estjuandcastaneda-06/Parcial-2-corte-/planos/planos_completos.pdf

## PLANTA — placa superior transparente; en línea punteada lo que queda debajo

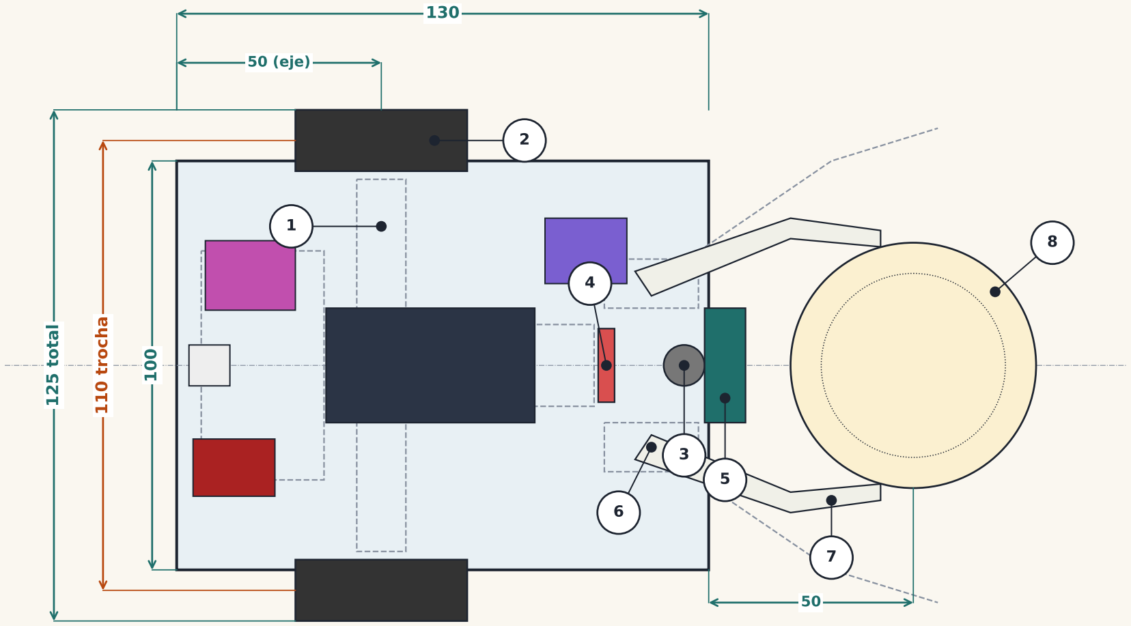
[picture p1: figure]
50 (eje); 110 trocha; 125 total
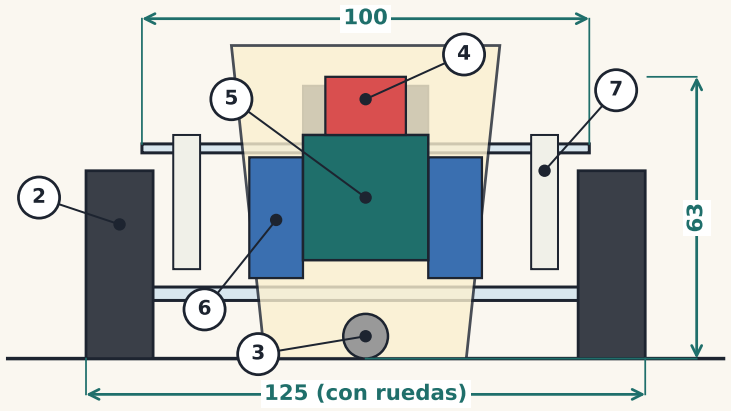
[picture p2: figure]
125 (con ruedas)

FRENTE

## VISTA LATERAL (el frente sale por la derecha)

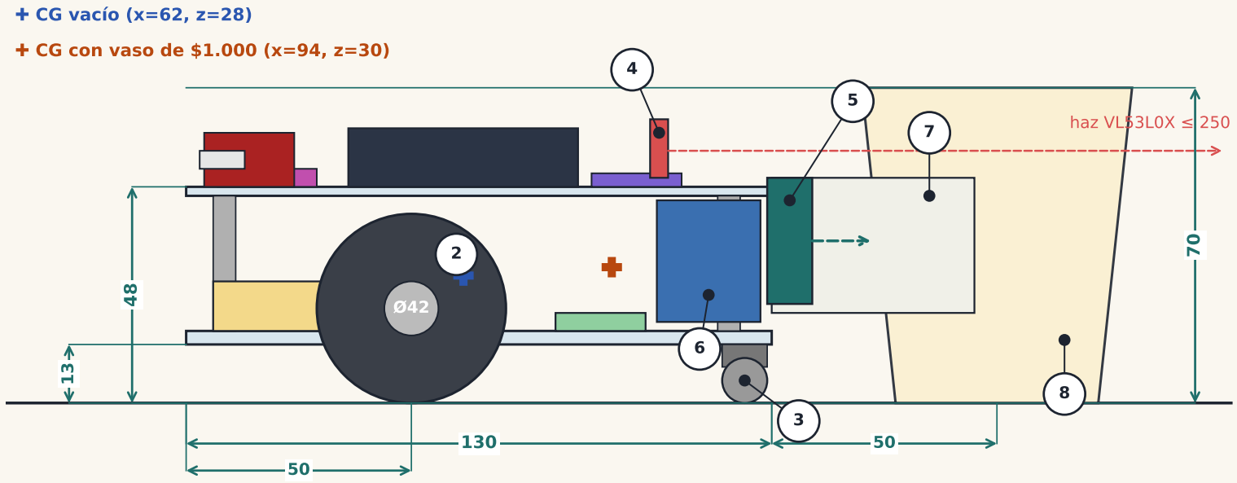
[picture p3: figure]
haz VL53L0X ≤ 250; ✚ CG vacío (x=62, z=28)

✚ CG con vaso de $1.000 (x=94, z=30) 48 13

## VISTA FRONTAL

## NOTAS

- Chasis de 2 placas (130×100; 3 y 2 mm), separadas 30 mm.
- Tracción diferencial, trocha 110 mm, eje a 50 mm del borde trasero.
- TCS3200 en la palma de la pinza, a ≈15 mm del vaso (su rango útil).
- VL53L0X atrás (x=105): con el vaso agarrado lee ≈45 mm (mín. fiable ≈30).
- Peso vacío 290 g; cargado 401 g (vaso + 10×$1.000).

## - CG con vaso en x=94 (entre eje 50 y loca 124): no vuelca

(límite ≥ 9.6 m/s²; el carrito usa < 1 m/s²).
- Medidas del vaso y de los N20/ruedas: supuestas, verificar con las piezas.

### LEYENDA

## 1 Motorreductor N20 + encoder (2) 2 Rueda Ø42 × 15 (2) 3 Rueda loca (bola Ø10) 4 VL53L0X: distancia / detecta vasos 5 TCS3200: color del vaso (en la palma) 6 Servo SG90 de la pinza (2) 7 Dedos de pinza impresos (2) 8 Vaso con 10 monedas (Ø60 × 70)

# Carrito hormiga — vistas y cotas

# Medidas en mm · tracción diferencial · pinza frontal con sensor de color en la palma

ENJAMBRE DE CARRITOS HORMIGA

## Lám. 1/7 · Esc. 1:1 por vista · mm

## Fecha 2026-10-04

## [Integrantes del grupo]

## PISO INFERIOR (sobre la placa de 3 mm) y zona de pinza entre placas

## PISO SUPERIOR (sobre la placa de 2 mm)

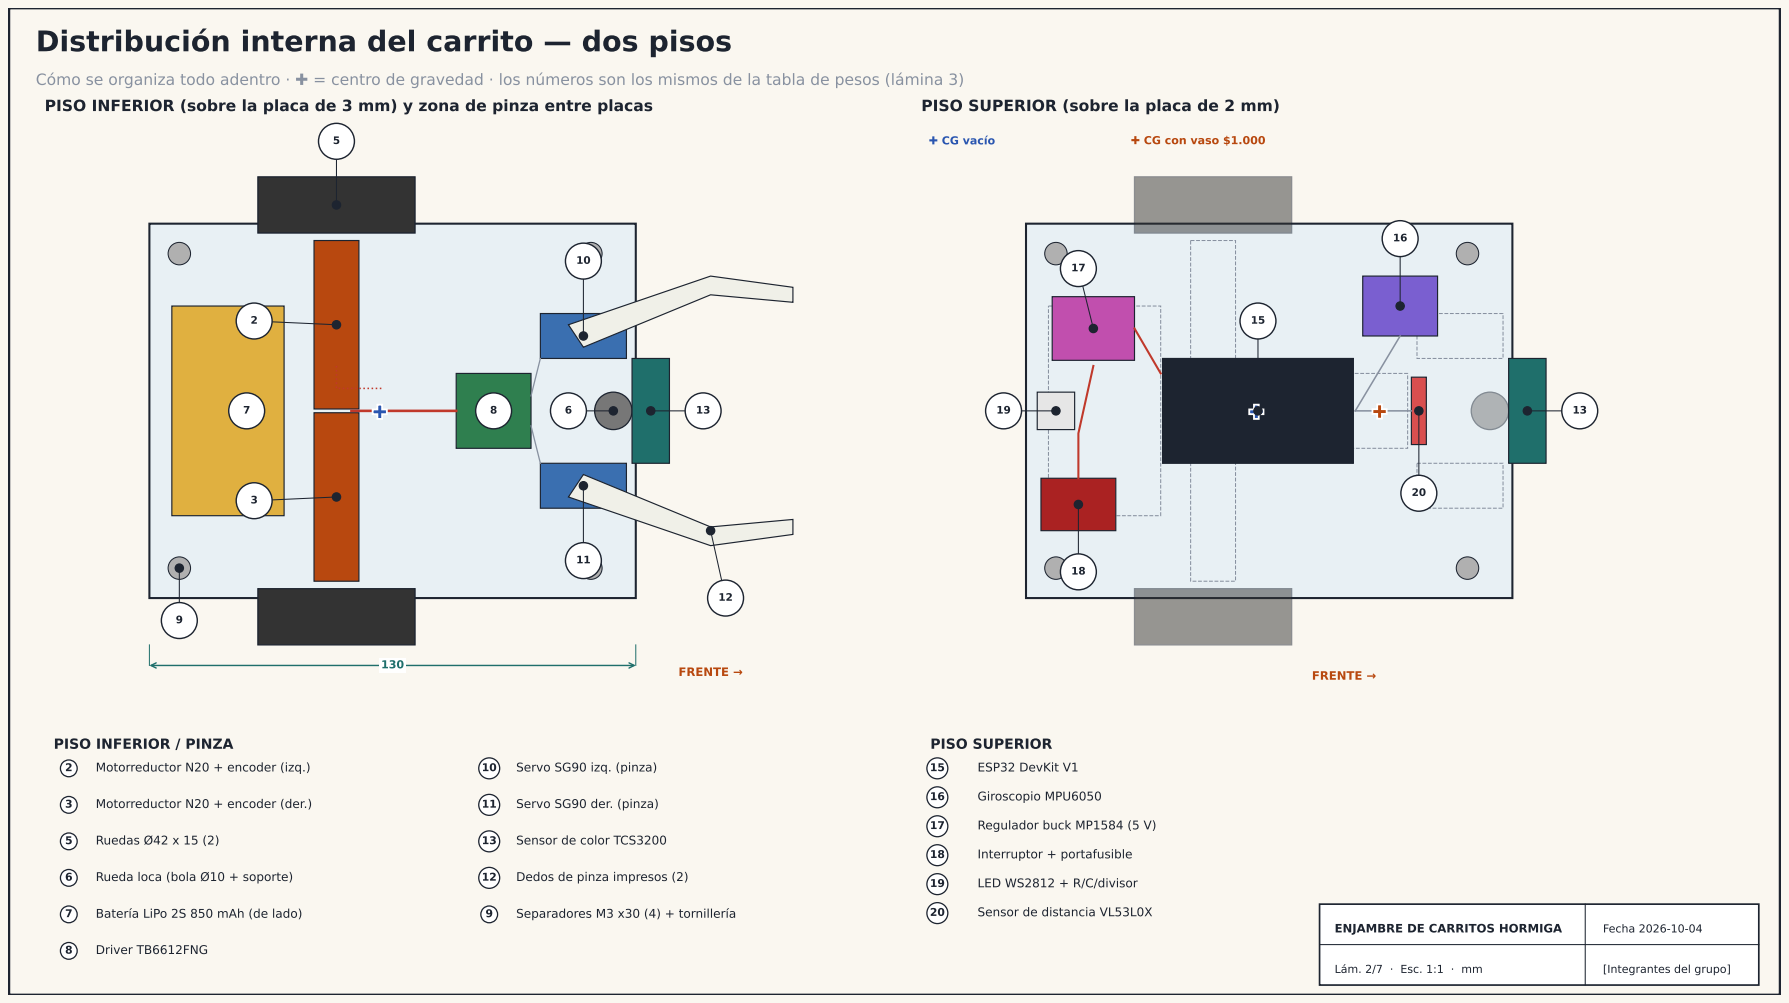
[picture p4: page 2]
FRENTE →; ✚ CG vacío; ✚ CG con vaso $1.000; 5 Ruedas Ø42 x 15 (2); 8 Driver TB6612FNG; 9 Separadores M3 x30 (4) + tornillería; PISO SUPERIOR; 15 ESP32 DevKit V1; 16 Giroscopio MPU6050; 17 Regulador buck MP1584 (5 V); 18 Interruptor + portafusible; 19 LED WS2812 + R/C/divisor

Distribución interna del carrito — dos pisos

Cómo se organiza todo adentro · ✚ = centro de gravedad · los números son los mismos de la tabla de pesos (lámina 3)

PISO INFERIOR / PINZA

2 Motorreductor N20 + encoder (izq.)

10 Servo SG90 izq. (pinza)

3 Motorreductor N20 + encoder (der.)

11 Servo SG90 der. (pinza)

13 Sensor de color TCS3200

6 Rueda loca (bola Ø10 + soporte)

12 Dedos de pinza impresos (2)

7 Batería LiPo 2S 850 mAh (de lado)

20 Sensor de distancia VL53L0X

Lám. 2/7 · Esc. 1:1 · mm

## PESO POR COMPONENTE (g)

N° | Componente | Piso | Masa
1 | Placa inferior acrílico 3 mm | inferior | 46
2 | Motorreductor N20 + encoder (izq.) | inferior | 14
3 | Motorreductor N20 + encoder (der.) | inferior | 14
4 | Soportes de motor (2) | inferior | 6
5 | Ruedas Ø42 x 15 (2) | inferior | 22
6 | Rueda loca (bola Ø10 + soporte) | inferior | 6
7 | Batería LiPo 2S 850 mAh (de lado) | inferior | 55
8 | Driver TB6612FNG | inferior | 3
9 | Separadores M3 x30 (4) + tornillería | inferior | 14
10 | Servo SG90 izq. (pinza) | pinza | 9
11 | Servo SG90 der. (pinza) | pinza | 9
12 | Dedos de pinza impresos (2) | pinza | 8
13 | Sensor de color TCS3200 | pinza | 12
14 | Placa superior acrílico 2 mm | superior | 31
15 | ESP32 DevKit V1 | superior | 10
16 | Giroscopio MPU6050 | superior | 3
17 | Regulador buck MP1584 (5 V) | superior | 2
18 | Interruptor + portafusible | superior | 8
19 | LED WS2812 + R/C/divisor | superior | 4
20 | Sensor de distancia VL53L0X | superior | 1.5
21 | Cableado y terminales | superior | 12
| MASA DEL CARRITO VACÍO | | 290 g
| + vaso (12 g) con 10 monedas de $1.000 (9,95 g c/u) | | 112 g
| MASA CARGADO (peor caso) | | 401 g

Carga útil por denominación (vaso de 12 g + 10 monedas): $50: 32 g $100: 45 g $200: 58 g $500: 83 g $1000: 112 g

0.00 | 0.25 | 0.50 | 0.75 | 1.00 | 1.25 | 1.50 | 1.75 | 2.00
potencia media tomada de la batería (W)

2× motor N20

ESP32 + ESP-NOW

Sensores (color,
ToF, IMU, enc.)

2× servo SG90
(uso medio)

LED WS2812

### 1.60 W

### 0.91 W

### 0.45 W

### 0.23 W

### 0.06 W

## CONSUMO MEDIO TOTAL ≈ 3.24 W

## CORRIENTES Y DIMENSIONAMIENTO

| media | pico
Riel 5 V (ESP32 + sensores + servos + LED) | 289 mA | 1449 mA
Batería 7,4 V (todo, con pérdidas del buck/driver) | 438 mA | 2194 mA
Potencia total | 3.2 W | 16.2 W
- Batería LiPo 2S 850 mAh = 6.29 Wh; usable 80 % → autonomía ≈ 1.6 h (teórica; esperar ≈1 h real).
- Pico = ambos motores bloqueados (600 mA c/u) + ambos servos a

500 mA: dura < 1 s.

- Buck MP1584 (3 A) con condensador de 1000 µF en el riel de 5 V:

los servos NO deben reiniciar el ESP32.

- Fusible de 3 A en la batería; motores N20 de 6 V con PWM

limitado al 80 % (batería 7,4 V).

- TB6612FNG: 1,2 A continuos por canal: sobra para 2 N20 (< 0,6 A

de pico).

## RESUMEN

290 g

vacío

401 g

con vaso de $1.000 (peor caso)

# 3.2 W

consumo medio (438 mA a 7,4 V)

≈ 1.6 h

autonomía teórica

# x = 94 mm

CG con vaso (eje 50 · loca 124)

# 9.6 m/s²

aceleración que haría volcar (uso real < 1)

# Peso, consumo y estabilidad del carrito

## Valores estimados con hojas de datos típicas: hay que pesar y medir las piezas reales

Lám. 3/7 · Esc. s/e · mm

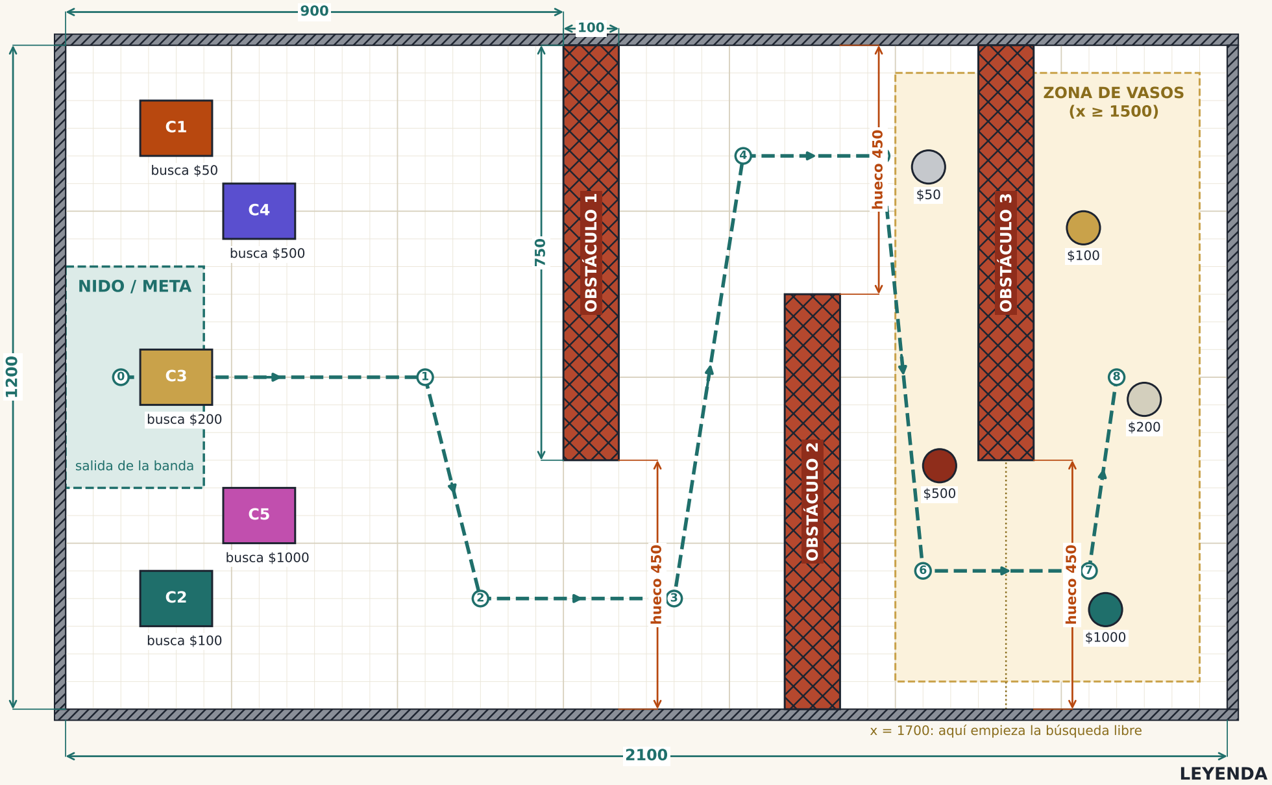
[picture p5: figure]
NIDO / META; salida de la; banda; ZONA DE VASOS; OBSTÁCULO 1; OBSTÁCULO 2; OBSTÁCULO 3; busca $1000; busca $50; busca $100; busca $200; busca $500; hueco 450; LEYENDA

x = 1700: aquí empieza la búsqueda libre

COORDENADAS (mm; origen en la esquina superior izquierda, x → derecha, y ↓ abajo)

- Nido / meta: (100, 600) · bahía de entrega 250 × 400
- Obstáculo 1: x 900–1000, y 0–750 · Obstáculo 2: x 1300–1400, y 450–1200 · Obstáculo 3: x 1650–1750, y 0–750
- Corredor 0→8: (100,600) (650,600) (750,1000) (1100,1000) (1225,200) (1475,200) (1550,950) (1850,950) (1900,600)
- Salidas: C1 (200,150) · C2 (200,1000) · C3 (200,600) · C4 (350,300) · C5 (350,850) → cada carrito busca UNA denominación
- Paredes de 60 mm de alto (el VL53L0X las ve y el campo potencial las evita). Piso mate claro, sin brillos (TCS3200).
- Cuadrícula de la simulación: 42 × 24 celdas de 50 mm (línea fina); cada 300 mm línea gruesa.
obstáculo (pared 60 mm) | corredor nido → zona
zona de vasos | nido / meta

# Plano de la arena de los carritos

## Mismas coordenadas que usa la simulación (swarm.py) y el URDF de PyBullet · cotas en mm

Lám. 4/7 · Esc. ≈ 1:10 · mm

## VISTA SUPERIOR — arena de 2100 × 1200 mm (1 hoja de MDF de 1220 × 2440 mm)

Flechas: salida del ESP32 → módulo (OUT) · módulo → ESP32 (IN: encoders y OUT del TCS3200) · punto = bus compartido

## ALIMENTACIÓN

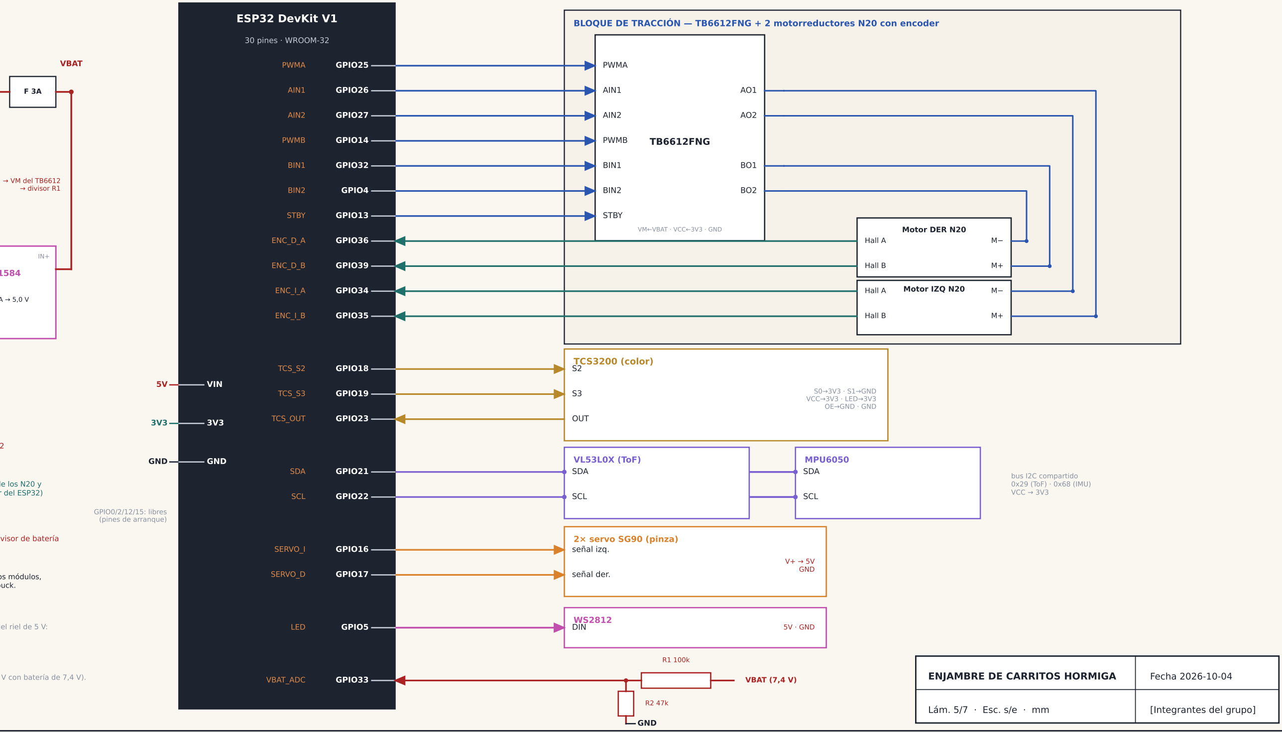
[picture p6: figure]
bus I2C compartido 0x29 (ToF) · 0x68 (IMU) VCC → 3V3; VBAT (7,4 V); VBAT; → VM del TB6612 → divisor R1; ESP32 DevKit V1; 30 pines · WROOM-32; PWMA; GPIO25; AIN1; GPIO26; AIN2; GPIO27; PWMB; GPIO14; BIN1; GPIO32; BIN2; GPIO4; STBY; GPIO13; ENC_D_A; GPIO36; ENC_D_B; GPIO39; ENC_I_A; GPIO34; ENC_I_B; GPIO35; TCS_S2; GPIO18; TCS_S3; GPIO19; TCS_OUT; GPIO23; SDA; GPIO21; SCL; GPIO22; SERVO_I; GPIO16; SERVO_D; GPIO17; LED; GPIO5; VBAT_ADC; GPIO33; VIN; GND; GPIO0/2/12/15: libres (pines de arranque); TB6612FNG; VM←VBAT · VCC←3V3 · GND; Motor DER N20; Motor IZQ N20; Hall A; Hall B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
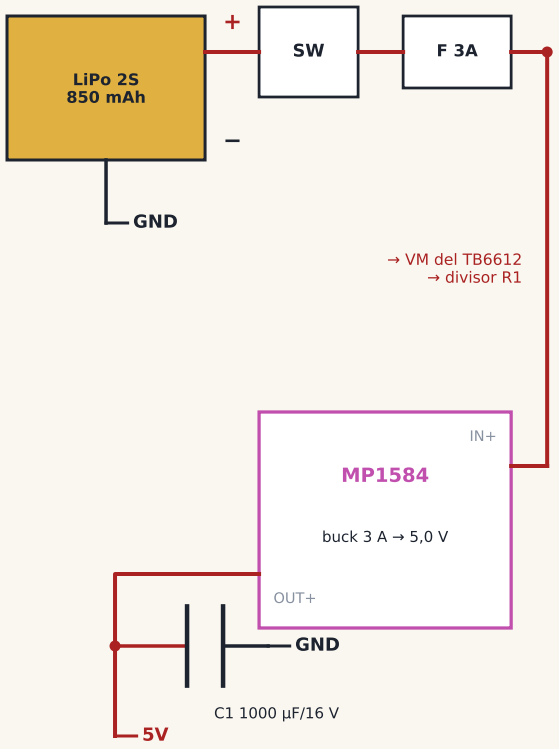
[picture p7: figure]
LiPo 2S 850 mAh; GND; buck 3 A → 5,0 V; OUT+

5V → ESP32 (VIN), 2× SG90 (V+), WS2812

3V3 → TCS3200, VL53L0X, MPU6050, Hall de los N20 y VCC lógico del TB6612FNG (regulador del ESP32)

VBAT → VM del TB6612FNG (motores) y divisor de batería

GND común: batería, buck, ESP32 y todos los módulos, unidos en UN solo punto (estrella) junto al buck.

Los picos de 2×500 mA de los servos caen del riel de 5 V: C1 evita que reinicien el ESP32.

PWM de motores limitado al 80 % (N20 de 6 V con batería de 7,4 V).

BLOQUE DE TRACCIÓN — TB6612FNG + 2 motorreductores N20 con encoder

# Esquema eléctrico del carrito — conexiones al ESP32

Cada GPIO va a su módulo; los pines salen de datos_carrito.py (la misma tabla que usa el firmware) · la hoja 5b es la tabla de conexiones

## SEÑALES DEL ESP32 (DevKit V1, 30 pines)

GPIO | Dir. | Señal | Módulo | Pin del módulo | Nota
25 | OUT | PWMA | TB6612FNG | PWMA | PWM 20 kHz (LEDC canal 4) · velocidad motor izq.
26 | OUT | AIN1 | TB6612FNG | AIN1 | dirección motor izq. (con AIN2)
27 | OUT | AIN2 | TB6612FNG | AIN2 | dirección motor izq. (con AIN1)
14 | OUT | PWMB | TB6612FNG | PWMB | PWM 20 kHz (LEDC canal 5) · velocidad motor der. · saca PWM al arrancar
32 | OUT | BIN1 | TB6612FNG | BIN1 | dirección motor der. (con BIN2)
4 | OUT | BIN2 | TB6612FNG | BIN2 | dirección motor der. (con BIN1)
13 | OUT | STBY | TB6612FNG | STBY | STBY: alto = habilita el puente H (bajo al arrancar)
34 | IN | ENC_I_A | Motor izq. N20 | Hall A | solo entrada · interrupción (flancos de A)
35 | IN | ENC_I_B | Motor izq. N20 | Hall B | solo entrada · sentido de giro del motor izq.
36 | IN | ENC_D_A | Motor der. N20 | Hall A | solo entrada (VP) · interrupción (flancos de A)
39 | IN | ENC_D_B | Motor der. N20 | Hall B | solo entrada (VN) · sentido de giro del motor der.
18 | OUT | TCS_S2 | TCS3200 | S2 | elige el filtro de color (con S3)
19 | OUT | TCS_S3 | TCS3200 | S3 | elige el filtro de color (con S2)
23 | IN | TCS_OUT | TCS3200 | OUT | salida del TCS3200: frecuencia → pulseIn()
21 | I/O | SDA | VL53L0X + MPU6050 | SDA | I2C 400 kHz · VL53L0X (0x29) + MPU6050 (0x68)
22 | OUT | SCL | VL53L0X + MPU6050 | SCL | I2C 400 kHz
16 | OUT | SERVO_I | Servo SG90 izq. | señal | PWM 50 Hz · ESP32Servo
17 | OUT | SERVO_D | Servo SG90 der. | señal | PWM 50 Hz · ESP32Servo
5 | OUT | LED | WS2812 | DIN | 1 LED WS2812; pin de arranque: parpadea al reiniciar
33 | IN | VBAT_ADC | Divisor 100k/47k | punto medio | ADC1_CH5 · 7,4 V × 47/147 = 2,4 V (máx. 8,4 V → 2,7 V). Nunca ADC2 con Wi-Fi/ESP-NOW

## REDES DE ALIMENTACIÓN

VBAT
7,4 V

LiPo 2S → interruptor → fusible 3 A

TB6612 (VM) · entrada del buck MP1584 · R1 del divisor

### 5 V

salida del buck MP1584 (3 A) + C1 1000 µF

ESP32 (VIN) · 2× SG90 (V+) · WS2812 (VDD)

3V3

regulador del ESP32 (≈80 mA de carga)

TCS3200 (VCC, S0, LED) · VL53L0X · MPU6050 · Hall de los N20 · TB6612 (VCC)

GND

un solo punto (estrella) junto al buck

todos los módulos; los servos y motores regresan por cables gruesos

## OBSERVACIONES DE CABLEADO

- Motor izquierdo en los canales A del TB6612 (AO1/AO2) y derecho en los

B (BO1/BO2). Si un motor gira al revés, se invierten sus cables o el signo en el firmware.

- Los encoders se alimentan con 3V3 (no con 5 V) para que sus salidas

sean seguras para el ESP32.

- S0 va fijo a 3V3 y S1 a GND (escala de frecuencia 20 %): ahorra 2

pines.

- GPIO34/35/36/39 son solo entrada y sin pull-up interno: si el encoder de tus N20 es de colector abierto, ponle 10 kΩ a 3V3.
- GPIO0, 2, 12 y 15 quedan sin usar: son pines de arranque y pueden

impedir que el ESP32 inicie.

- El canal Wi-Fi/ESP-NOW es el 1 en los 5 carritos y en la estación del

nido.

# Tabla de conexiones del carrito

Complemento del esquema eléctrico: qué va a cada pin y de dónde sale cada riel de alimentación

Lám. 5b/7 · Esc. s/e · mm

ESTACIÓN CENTRAL (ESP32 #0): contador + banda + brazo de embalaje + báscula del nido

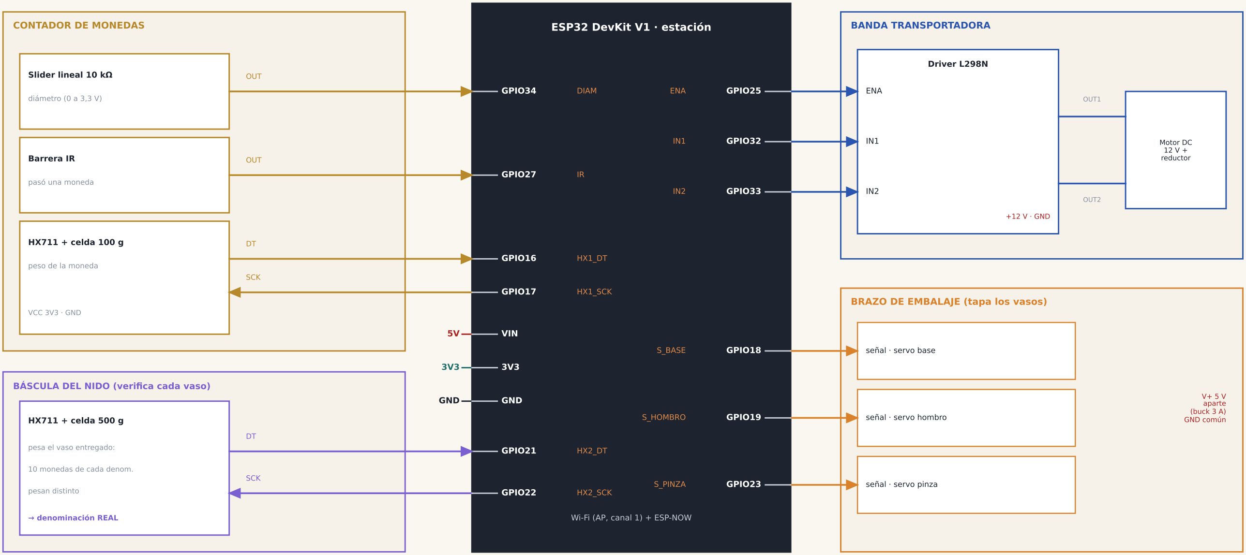
[picture p8: figure]
OUT; SCK; OUT1; OUT2; ESP32 DevKit V1 · estación; GPIO34; DIAM; GPIO27; GPIO16; GPIO17; HX1_SCK; GPIO21; GPIO22; HX2_SCK; ENA; GPIO25; GPIO32; GPIO33; S_BASE; GPIO18; S_HOMBRO; GPIO19; S_PINZA; GPIO23; VIN; GND; Wi-Fi (AP, canal 1) + ESP-NOW; CONTADOR DE MONEDAS; Slider lineal 10 kΩ; diámetro (0 a 3,3 V); Barrera IR; pasó una moneda; HX711 + celda 100 g; peso de la moneda; VCC 3V3 · GND; BÁSCULA DEL NIDO (verifica cada vaso); HX711 + celda 500 g; pesa el vaso entregado:; 10 monedas de cada denom.; pesan distinto; → denominación REAL; BANDA TRANSPORTADORA; Driver L298N; +12 V · GND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

ALIMENTACIÓN DE LA ESTACIÓN

+12 V → L298N y motor de la banda

5 V → ESP32 (VIN) · servos del brazo · HX711 · C 1000 µF

GND común de toda la estación en un solo punto

RED Y COMUNICACIÓN

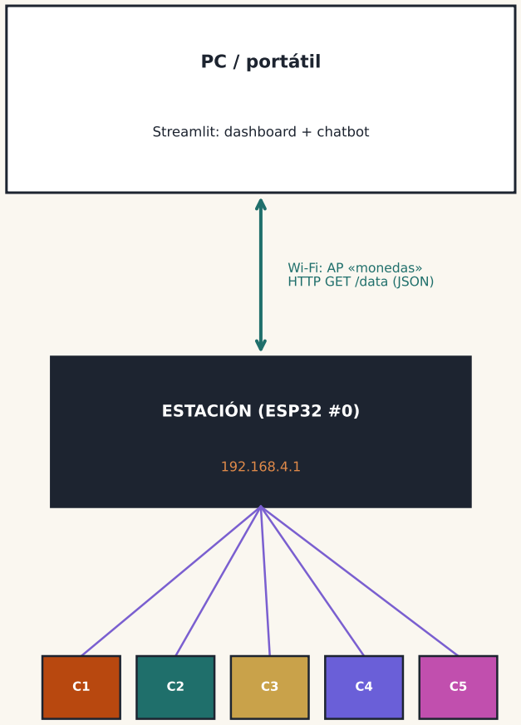
[picture p9: figure]
Wi-Fi: AP «monedas» HTTP GET /data (JSON); PC / portátil; Streamlit: dashboard + chatbot; ESTACIÓN (ESP32 #0)

malla ESP-NOW · canal 1 · broadcast

MENSAJES (≤ 250 B)

DEPÓSITO · 5 B

carrito → todos: id, celda (x,y), cantidad de

feromona

TELEMETRÍA · 15 B

carrito → todos: estado, errores, entregas bien/mal, falsos por denominación

VERIFICACIÓN · 3 B

estación → carrito: denominación REAL pesada en el

nido

Fuente

### 12 V / 5 A

SW + fusible
5 A | Buck 12→5 V / 3 A

# Esquema eléctrico y de comunicación de todo el proyecto

Estación central + red ESP-NOW de 5 carritos + PC · los pines de la estación son diseño: su firmware aún está pendiente

Lám. 6/7 · Esc. s/e · mm

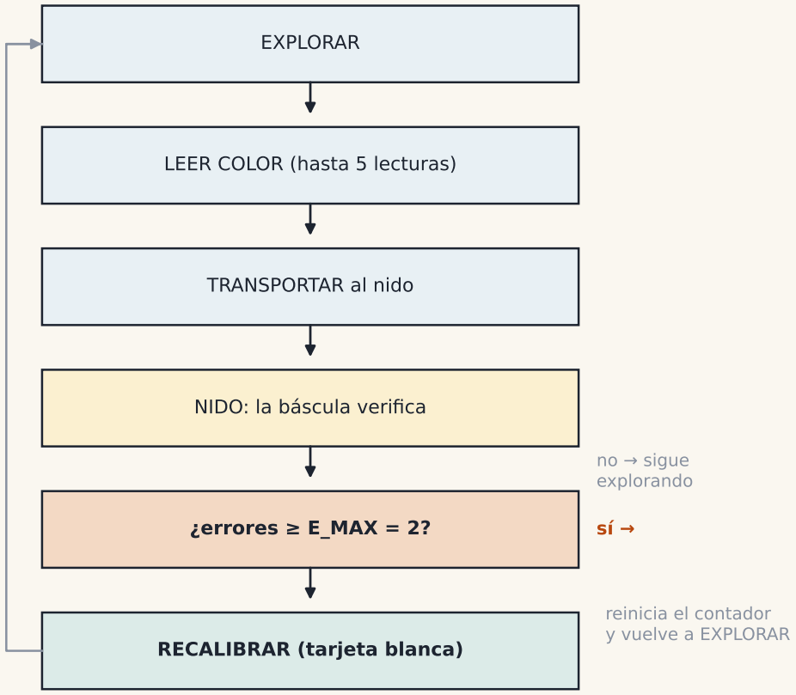
[picture p10: figure]
EXPLORAR; LEER COLOR (hasta 5 lecturas); TRANSPORTAR al nido; NIDO: la báscula verifica; ¿errores ≥ E_MAX = 2?; RECALIBRAR (tarjeta blanca); no → sigue; explorando; reinicia el contador y vuelve a EXPLORAR
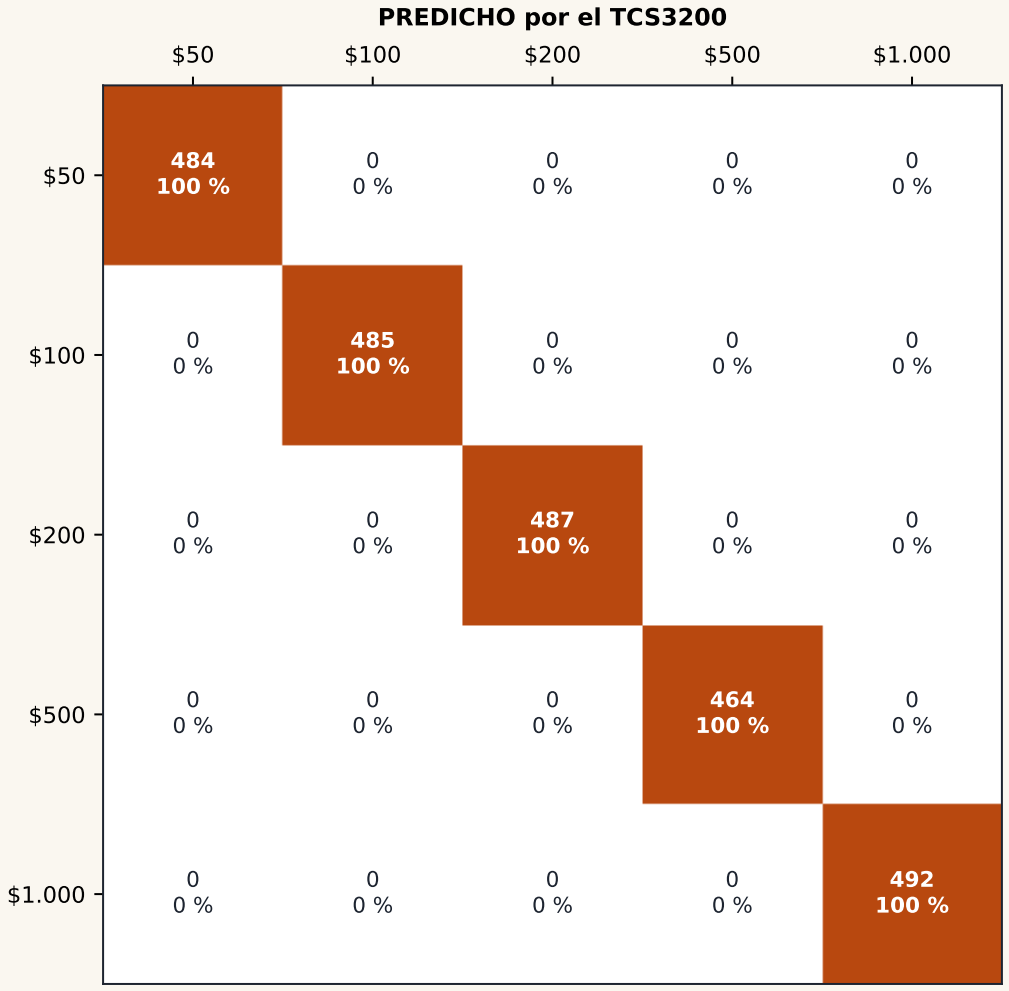
[picture p11: figure]
PREDICHO por el TCS3200

### DENOMINACIÓN REAL del vaso

2535 lecturas · exactitud 92.5 % · entregas equivocadas 16 de 1072

### Paleta actual (plateado, dorado, beige, rojo, verde)

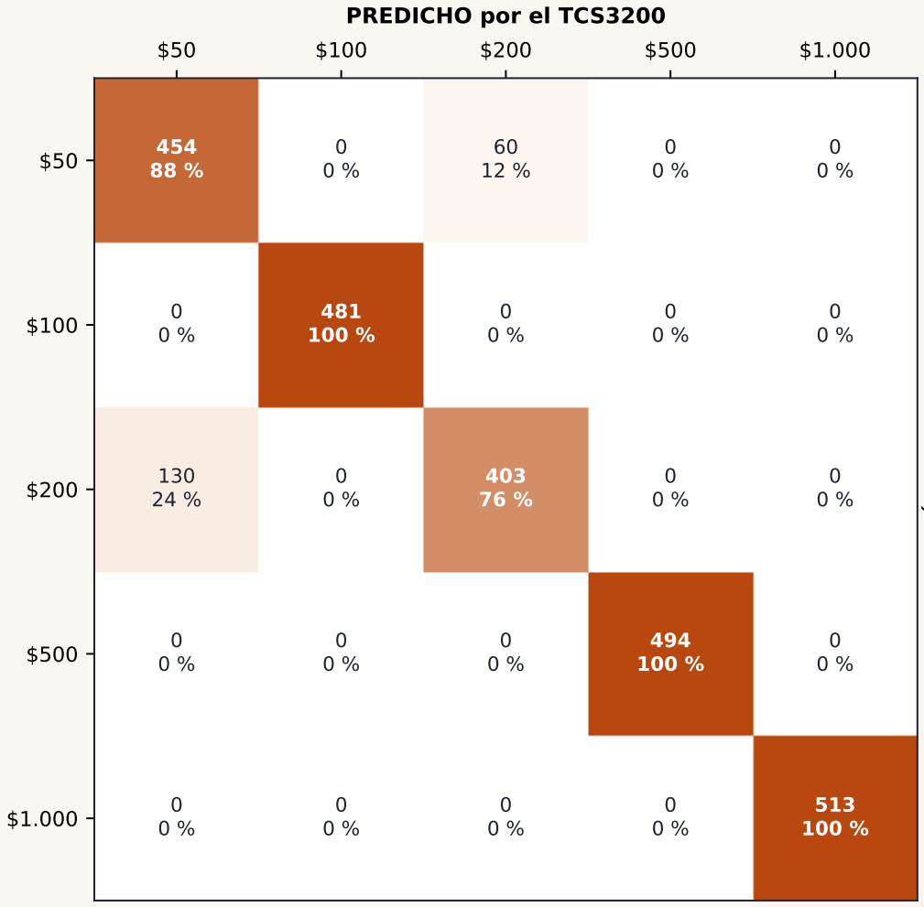
[picture p12: figure]
PREDICHO por el TCS3200

### DENOMINACIÓN REAL del vaso

2412 lecturas · exactitud 100.0 % · entregas equivocadas 0 de 1408

### Paleta recomendada (blanco, amarillo, azul, rojo, verde)

## REGLA DE ERRORES (idea del profe)

Resultado en simulación (6 corridas de 30 min, paleta actual):

deriva del sensor | regla | entregas OK | mal | % mal | recal.
baja | sin regla | 1084 | 23 | 2.1 % | 0
baja | E_MAX = 2 | 1056 | 16 | 1.5 % | 7
alta | sin regla | 653 | 65 | 9.1 % | 0
alta | E_MAX = 2 | 610 | 31 | 4.8 % | 13 • La matriz muestra que el error está casi todo en un par: $50 plateado ↔ $200 beige (cromaticidad casi igual). Exactitud de lectura 93 %.
- Con pegatinas blanco / amarillo / azul / rojo / verde la exactitud sube a 100 % y las entregas equivocadas pasan de 1.5 % a 0.0 %.
- Regla de E_MAX: con deriva alta las entregas equivocadas bajan de 9.1 % a 4.8 % y las entregas correctas pasan de 653 a 610; con deriva baja casi no cambia (2.1 % → 1.5 %) y las entregas correctas pasan de 1084 a 1056 (6 corridas de 30 min; diferencias de ~1 punto porcentual pueden ser ruido entre corridas).
- Es una simulación con ruido supuesto del sensor: hay que repetir la medida con el TCS3200 real (comando serial '0'..'4' del firmware) antes de fijar

umbrales.

# Matriz de confusión del sensor de color y regla de errores

Filas = denominación real · columnas = lo que predijo el TCS3200 · diagonal = acierto · datos de swarm.py (5 carritos, 6 × 30 min simulados)

Lám. 7/7 · Esc. s/e · mm
