estjuandcastaneda-06/Parcial-2-corte-/planos/05_esquema_carrito.pdf

Flechas: salida del ESP32 → módulo (OUT) · módulo → ESP32 (IN: encoders y OUT del TCS3200) · punto = bus compartido

# ALIMENTACIÓN

## VBAT

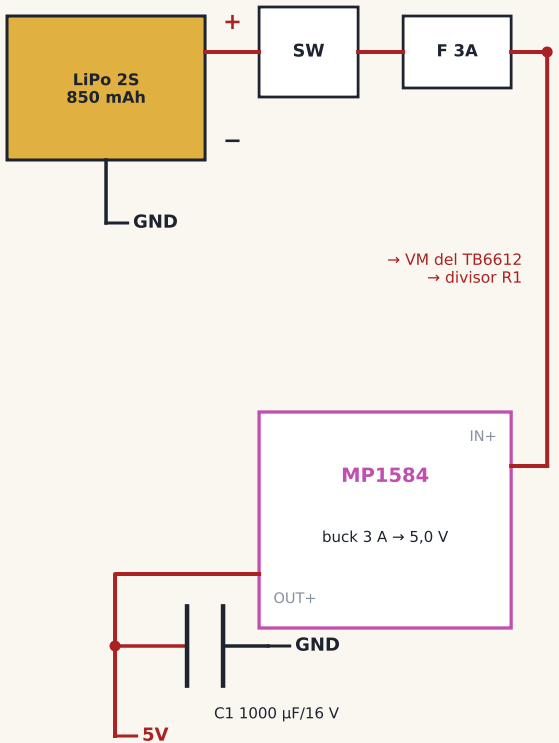
[picture p13: figure]
→ VM del TB6612 → divisor R1; LiPo 2S 850 mAh; GND; buck 3 A → 5,0 V; OUT+

5V → ESP32 (VIN), 2× SG90 (V+), WS2812

3V3 → TCS3200, VL53L0X, MPU6050, Hall de los N20 y VCC lógico del TB6612FNG (regulador del ESP32)

VBAT → VM del TB6612FNG (motores) y divisor de batería

GND común: batería, buck, ESP32 y todos los módulos, unidos en UN solo punto (estrella) junto al buck.

Los picos de 2×500 mA de los servos caen del riel de 5 V: C1 evita que reinicien el ESP32.

PWM de motores limitado al 80 % (N20 de 6 V con batería de 7,4 V).

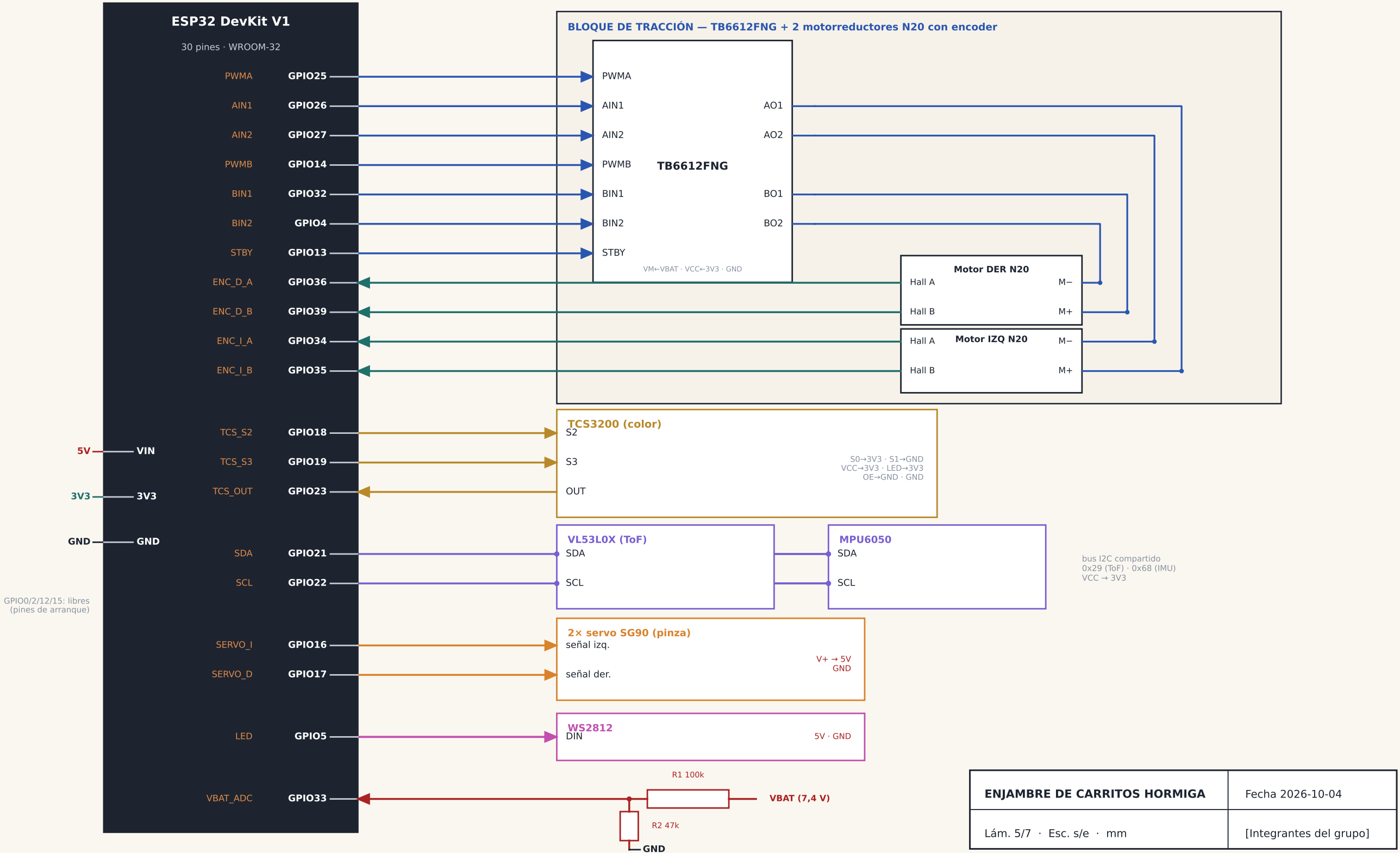
[picture p14: figure]
bus I2C compartido 0x29 (ToF) · 0x68 (IMU) VCC → 3V3; VBAT (7,4 V); ESP32 DevKit V1; 30 pines · WROOM-32; PWMA; GPIO25; AIN1; GPIO26; AIN2; GPIO27; PWMB; GPIO14; BIN1; GPIO32; BIN2; GPIO4; STBY; GPIO13; ENC_D_A; GPIO36; ENC_D_B; GPIO39; ENC_I_A; GPIO34; ENC_I_B; GPIO35; TCS_S2; GPIO18; TCS_S3; GPIO19; TCS_OUT; GPIO23; SDA; GPIO21; SCL; GPIO22; SERVO_I; GPIO16; SERVO_D; GPIO17; LED; GPIO5; VBAT_ADC; GPIO33; VIN; GND; GPIO0/2/12/15: libres (pines de arranque); TB6612FNG; VM←VBAT · VCC←3V3 · GND; Motor DER N20; Motor IZQ N20; Hall A; Hall B; TCS3200 (color) S2; OUT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

## BLOQUE DE TRACCIÓN — TB6612FNG + 2 motorreductores N20 con encoder

## GND

5V

# Esquema eléctrico del carrito — conexiones al ESP32

Cada GPIO va a su módulo; los pines salen de datos_carrito.py (la misma tabla que usa el firmware) · la hoja 5b es la tabla de conexiones
