estjuandcastaneda-06/Parcial-2-corte-/planos/01_vistas_carrito.png

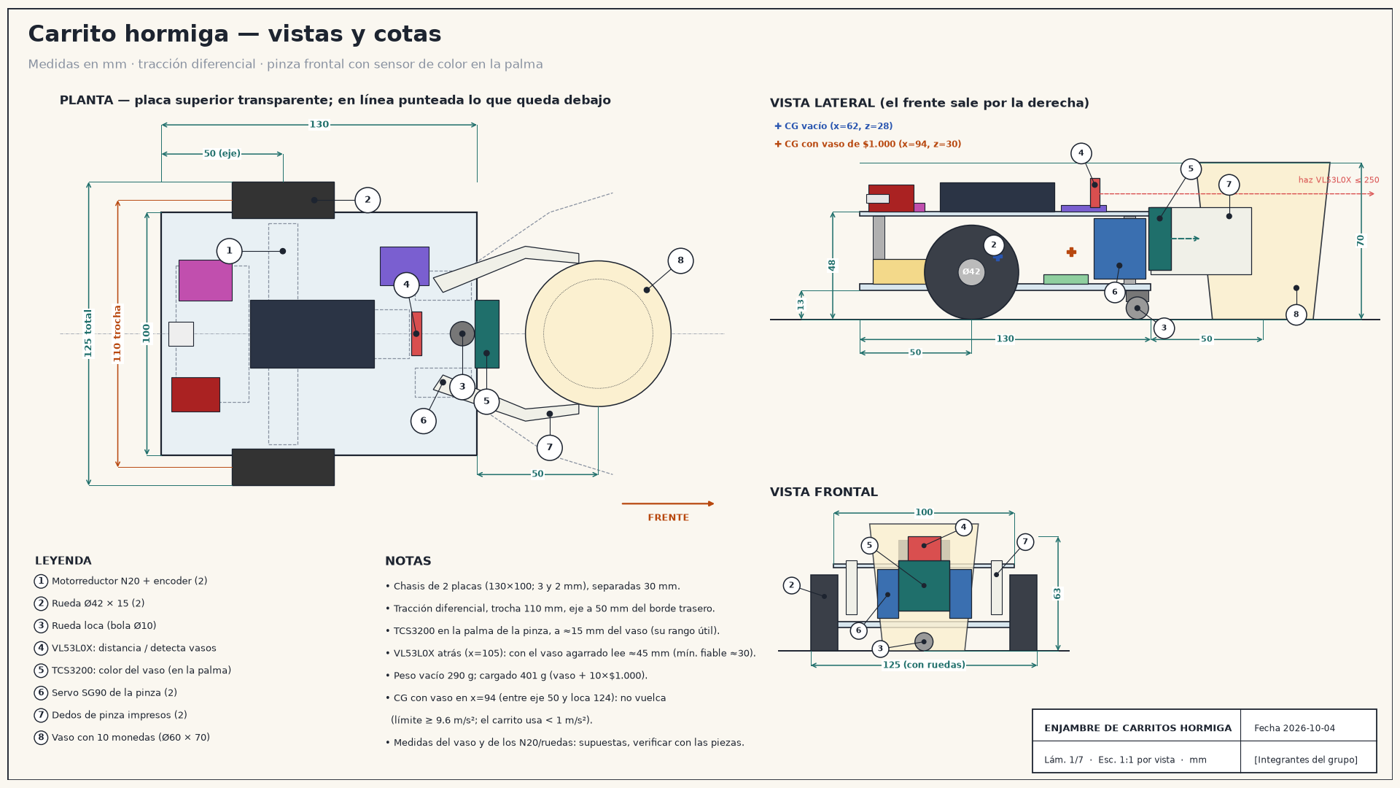
planos/01_vistas_carrito.png
