estjuandcastaneda-06/Parcial-2-corte-/planos/03_pesos_consumo.png

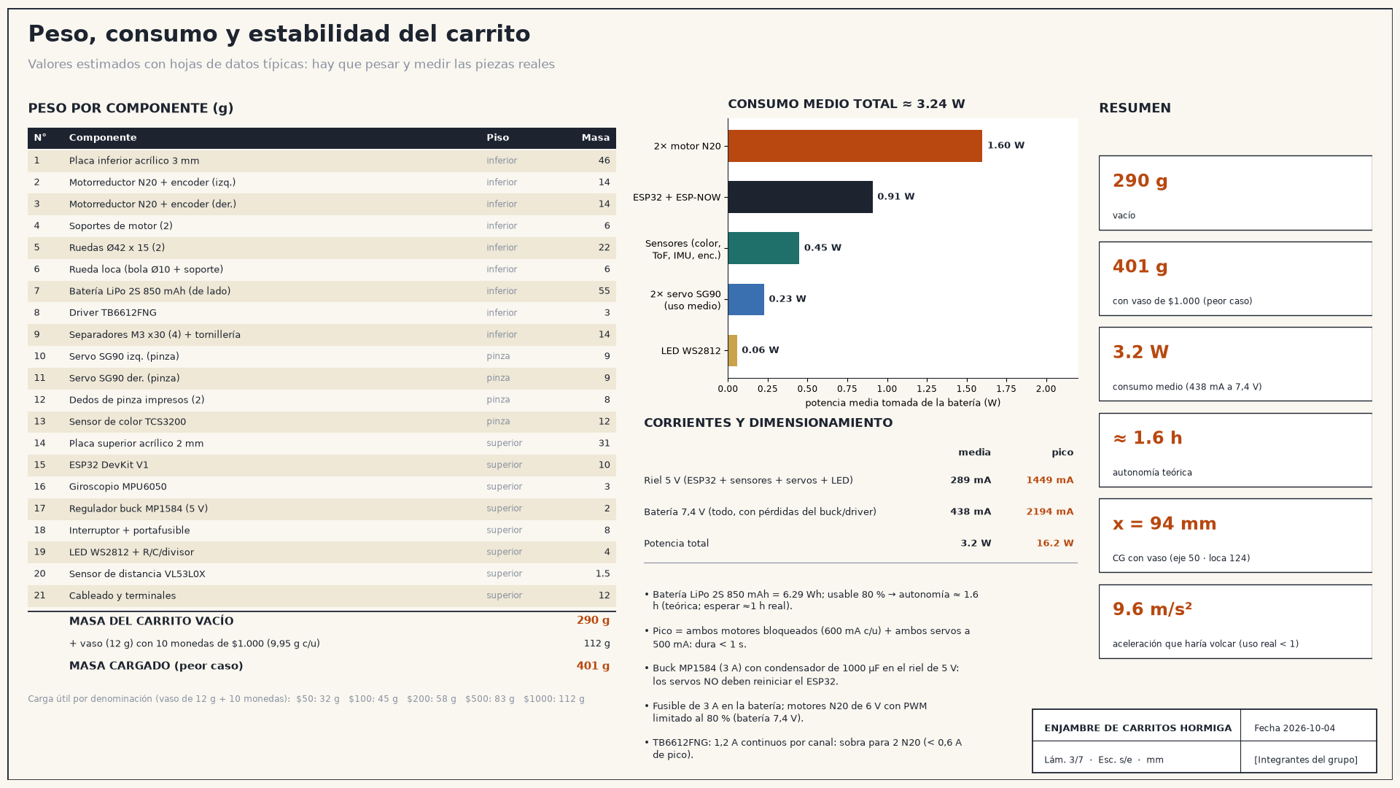
planos/03_pesos_consumo.png
