estjuandcastaneda-06/Parcial-2-corte-/planos/04_arena.png

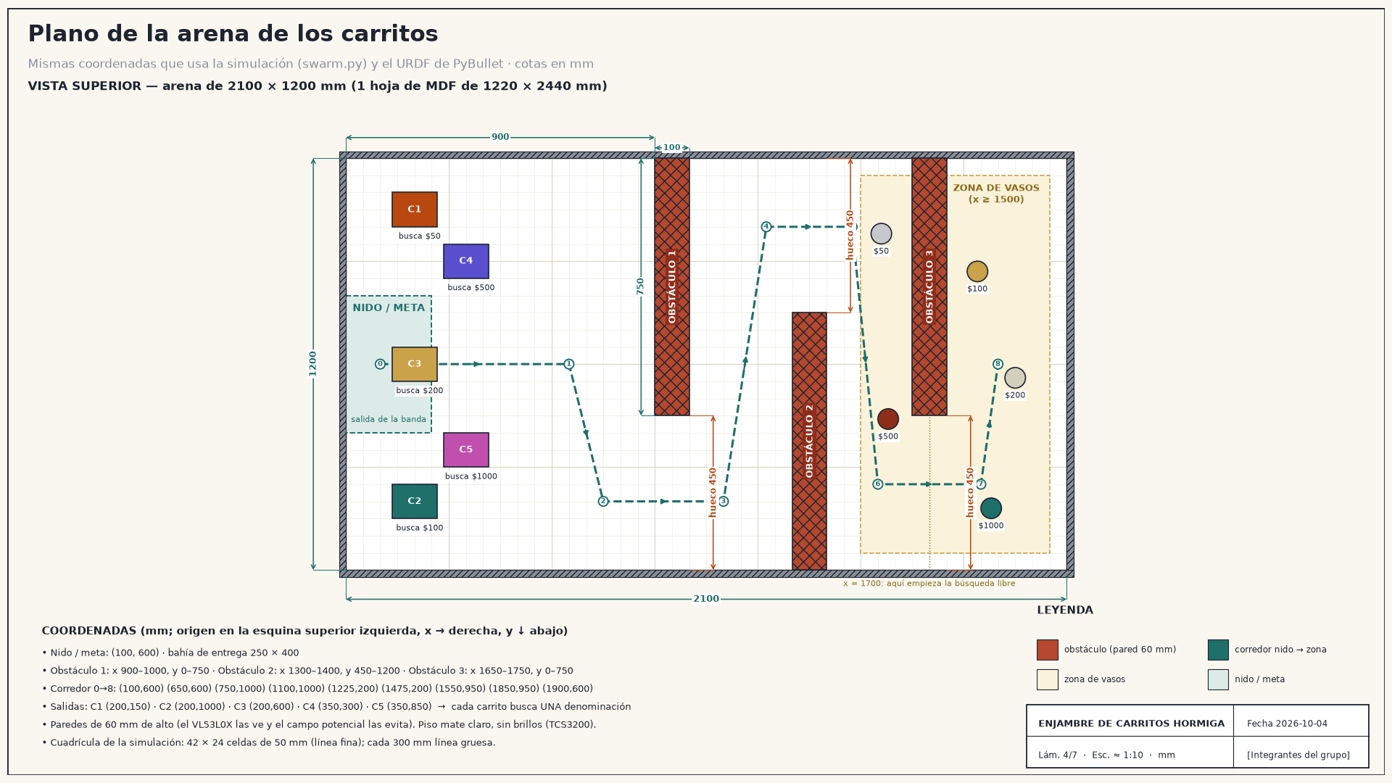
planos/04_arena.png
