estjuandcastaneda-06/Parcial-2-corte-/planos/05_esquema_carrito.png

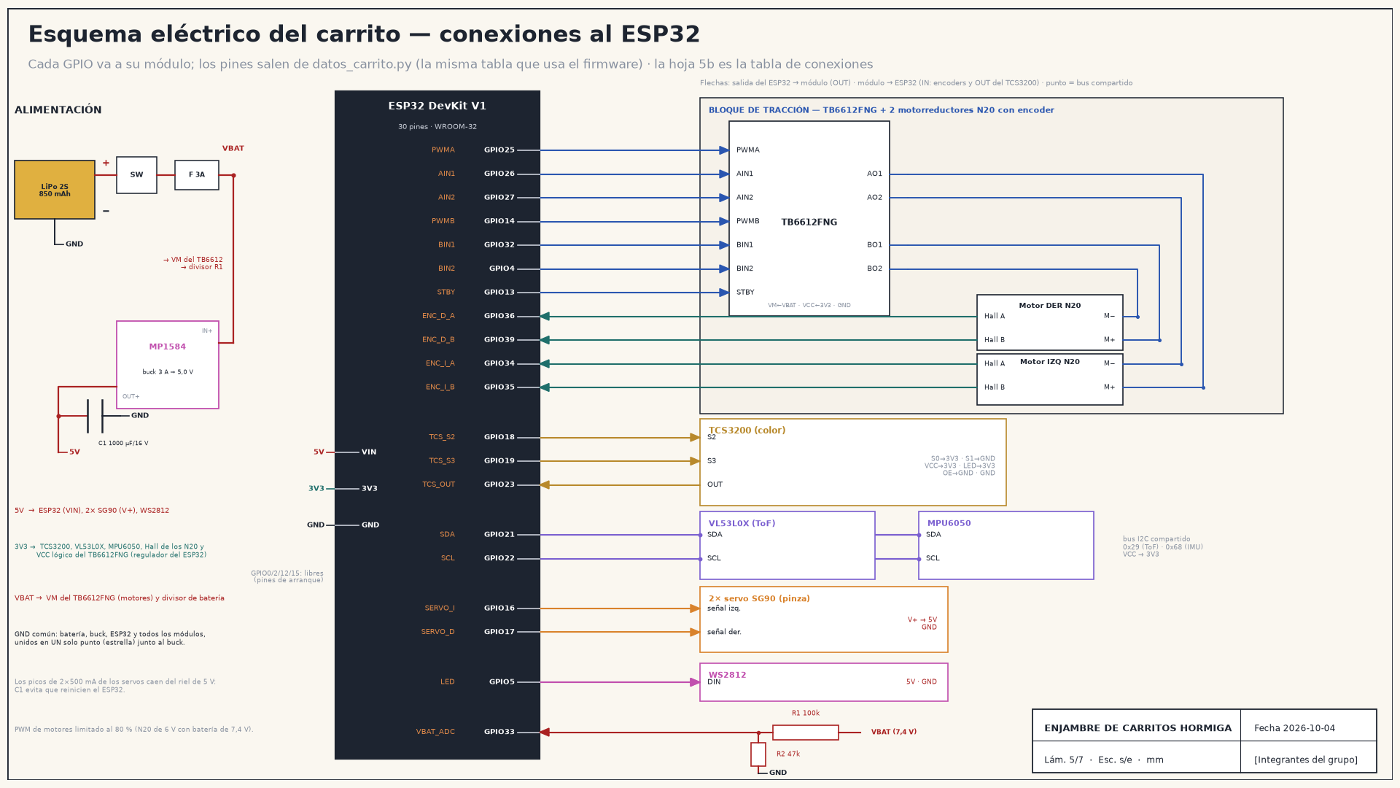
planos/05_esquema_carrito.png
