estjuandcastaneda-06/Parcial-2-corte-/planos/05b_tabla_conexiones.png

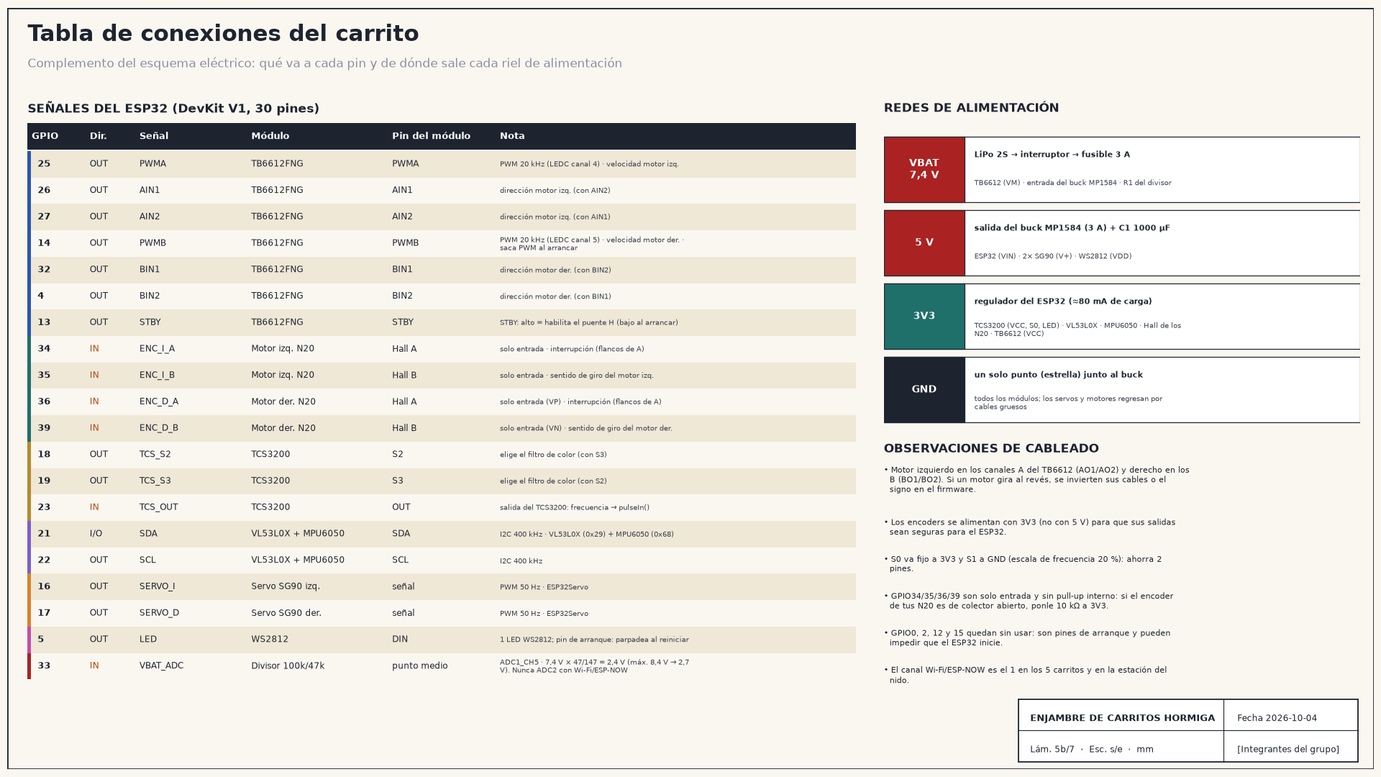
planos/05b_tabla_conexiones.png
