estjuandcastaneda-06/Parcial-2-corte-/planos/06_esquema_sistema.png

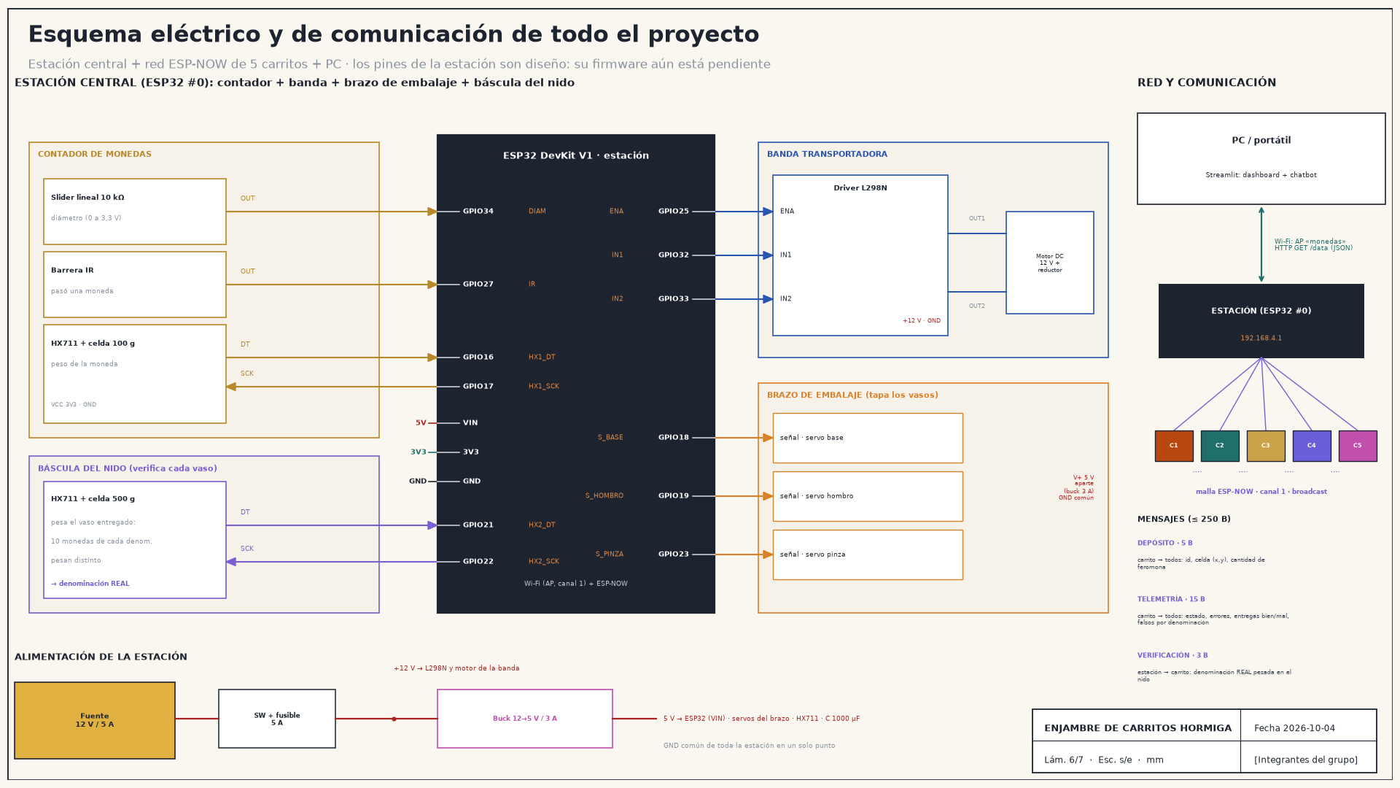
planos/06_esquema_sistema.png
