estjuandcastaneda-06/Parcial-2-corte-/planos/07_matriz_confusion.png

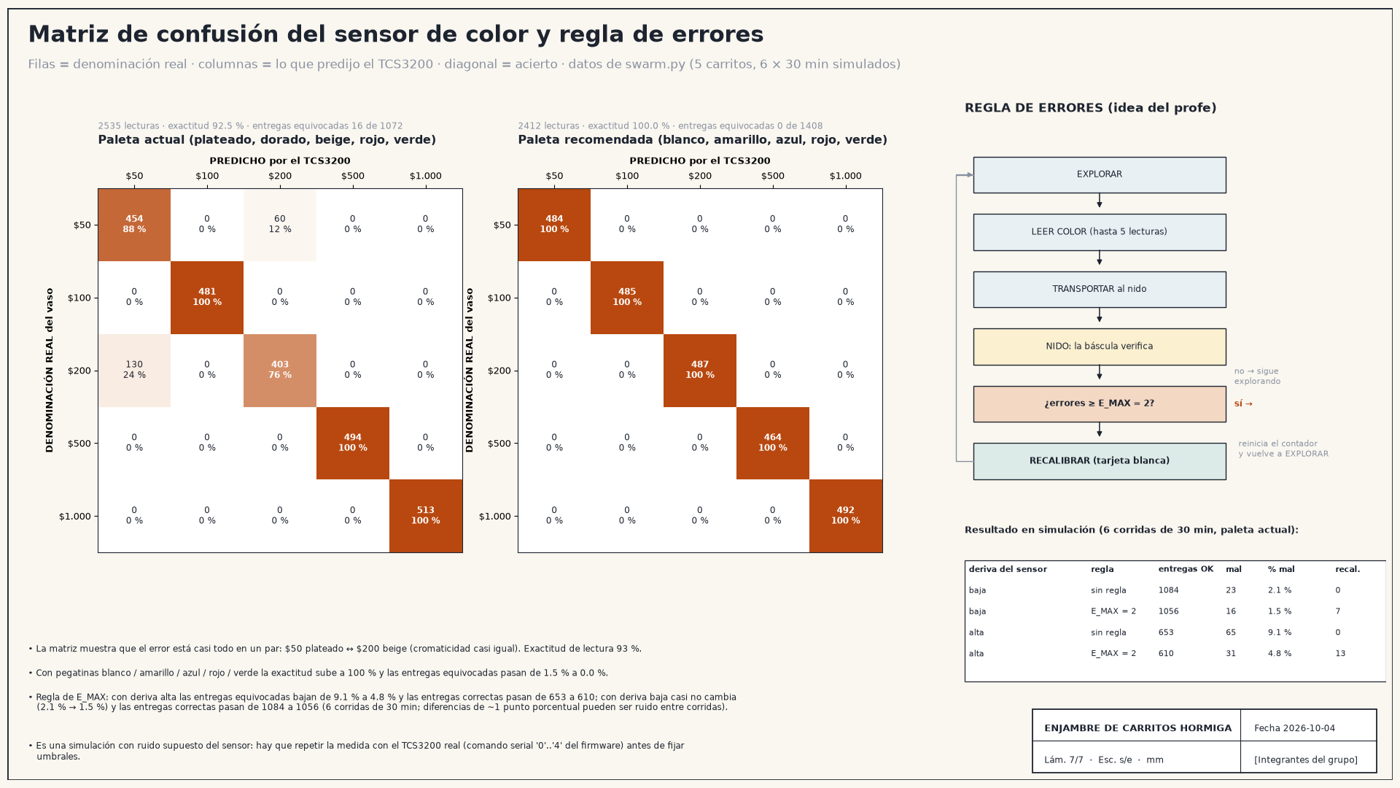
planos/07_matriz_confusion.png
